JD1694/BachelorProject-BicycleCrasher/README.md

# BachelorProject: Bicycle-Crash-Detection 2021
Bachelor project at the Universität zu Lübeck about real-time crash-detection on bicycles using IMU data.

This detection acts as the basic structure for a whole safty system. Once a crash is detected, that information can be relayed to various extentions that do not need their own sensors and only little computation power. These gadgets could e.g. activate an airbag, a dashcam or call an ambulance.

|  <ins>Further Reading:</ins> | Found in: |
|---|---|
|Overview as presentation slides | Dokumentation/SensorBike_Präsentation.pdf |
|Documentation | Dokumentation/Dokumentation Bachelorprojekt.pdf |
|Materials bought: | Dokumentation/Bach.-Projekt Materialien Denker, von Waldow - Tabellenblatt1.pdf |

Crash gif with live data

Authors:
- Max-Ole von Waldow
- Julian Denker

Supervised by:
- Prof. Dr. Georg Schildbach
