JD1694/BachelorProject-BicycleCrasher/Dokumentation/Bach.-Projekt Materialien Denker, von Waldow - Tabellenblatt1.pdf

Name | Preis | Spannung in V | Größe in m² | DoF | DigitalMotionProcessor | Takt in Mhz | Link
Vergleich IMU: | Makeblock Sensor Board | 25 | 5 | 24*48 | 9 | Ja
Grove IMU 9DoF MPU9250 | 13 | 5 | 20*40 | 9 | Nein
GY-521 MPU-6050 | 9 | 3,3-5 | 21*16 | 6 | Nein | https://www.az-delivery.de/products/gy-521-6-achsen-gyroskop-und-beschleunigungssensor?variant=18568447393888 https://www.az-delivery.de/products/copy-of-spi-reader-micro-speicherkartenmodul-fur-arduino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
Pololu Min IMU-9v5 | 17 | 2,5-5.5 | 12,7*20 | 9 | Nein

Vergleich Microcontroller:

ESP-8266 | 5-10 | 3,3-3,6 | 80
Blue Pill STM32 | 5-10 | 3,3 | 72 | https://www.az-delivery.de/products/stm32f103c8t6?variant=8196210884704
Teensy | 20 | 5 | 72
Arduino | 20+ | 5 | 16 | https://www.az-delivery.de/products/esp32-developmentboard
ESP32 | 8

Zusätzlich für manche Mikrocontroller benötigt:

USB to TTL Adapter | https://www.az-delivery.de/products/hw-598-usb-auf-seriell-adapter-mit-cp2102-chip-und-kabel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
SD Reader | https://www.az-delivery.de/products/copy-of-spi-reader-micro-speicherkartenmodul-fur-arduino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
