JD1694/BachelorProject-BicycleCrasher/Dokumentation/SensorBike_Präsentation.pdf

# Bachelorprojekt

# SensorBike aka BikeCrasher

# Zielsetzung

# - Fahrradstürze mit IMU vorhersagen - Um Module erweiterbare Plattform bilden

# Vorgehensplan

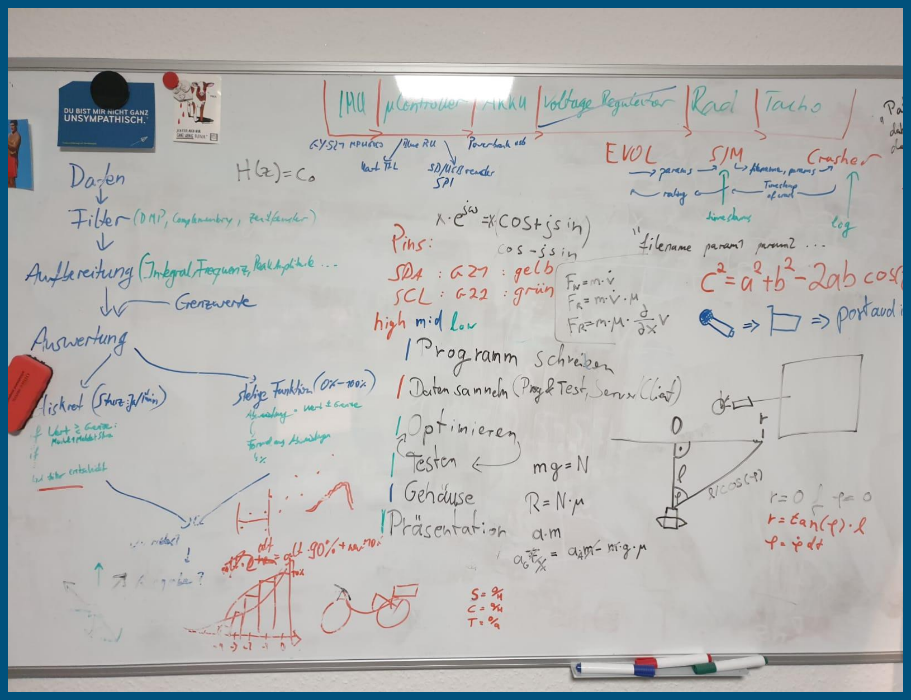
[picture p7: figure]

# - Treffen jeden Freitag - Absprache über Whatsapp und Discord - GitHub als Repository

https://github.com/JD1694/BachelorProject-BicycleCrasher

# Methoden

Daten sammeln-> ESP32-WROOM-32 mit Modulo MPU-6050 ausstatten, Clientprogramm zum Auslesen/Aufbereiten der Sensorwerte/Timestamps für Sturz in Arduino/C++, Hostprogramm empfängt Daten und schreibt in CSV in Python---->Gesammelte Sensorwerte

Auswerten der Daten-> Umschreiben des Programms zum Sammeln der Sensorwerte, sodass mithilfe der CSV eine “Simulation” ablaufen kann in C++, Sensorwerte werden aufbereitet und mit verschiedenen Thresholds verglichen, um festzustellen, ob momentan ein Sturz stattfindet. Parameter erhält das Programm von einem evolutionären Algorithmus (verschiedene Ansätze, final bruteforce) in Python, der unterschiedliche Parameter anhand der Abweichung des detektierten Sturzes verglichen mit dem aufgenommenen Timestamp bewertet---->Parameter zum erkennen eines Sturzes

Erkennen eines Sturzes->Umschreiben des Arduino/C++ Codes von Client zu Hostanwendung, wertet mit Hilfe von aufbereiteten Sensordaten und bestimmten Parametern Situation aus und sendet Informationen über Sturzverhalten/Sensordaten an Client---->Sturz erkannt

Zwischenschritte->Vorbereiten des Fahrrads (Polstern empfindlicher Stellen, abbauen des Sattels/Lichts, Aufhängung für Dummy(verworfen)), Vorbereiten des ESP(Anbringen von MPU, Einbau in gepolsterte Abzweigdose als Gehäuse)

Benötigt: Foto präpariertes Fahrrad, ESP32+MPU6050 (in Abzweigdose), Videomaterial, Codesnippets (eval, main-loop 1,2,3 Vergleich, genetic algo), Fotos von Webseite auf Handy, Plots (genAlg, Vergleich Timestamp ergebnis), Schaubilder für Vorgehen (“Datenpfad”, Optimierungskette,)

# Hardware

# Mikrocontroller: ESP32

# - integriertes Wi-Fi als Schnittstelle - 160-240MHz - FPU

# IMU: GY521-MPU

# - 3-Achsen Gyroskop und Accelerometer - DMP

# Aufbau

## Polster

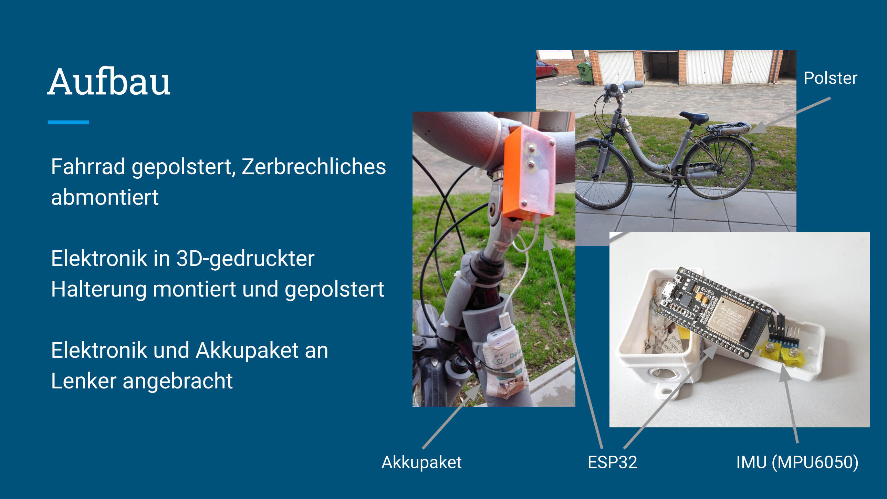
[picture p8: page 6]

# Fahrrad gepolstert, Zerbrechliches abmontiert

# Elektronik in 3D-gedruckter Halterung montiert und gepolstert

# Elektronik und Akkupaket an Lenker angebracht

Akkupaket | ESP32 | IMU (MPU6050)

# TOREMOVE - Meine Online Bildbearbeitung

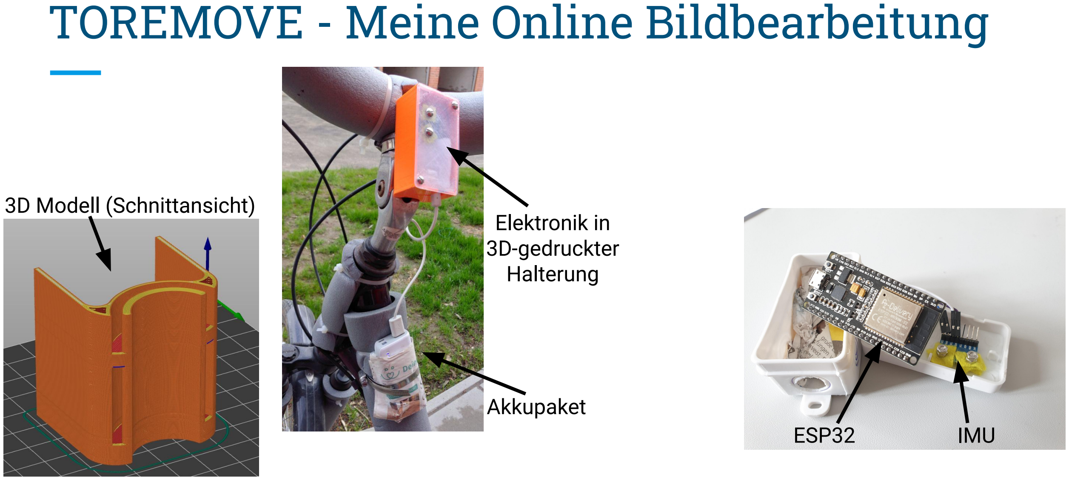
[picture p9: page 7]

## Akkupaket

ESP32 | IMU

## Elektronik in 3D-gedruckter Halterung

## 3D Modell (Schnittansicht)

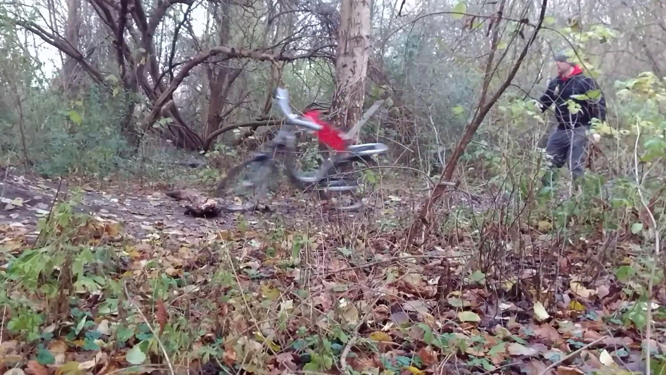
[picture p10: page 8]

# Schaubild: Daten sammeln

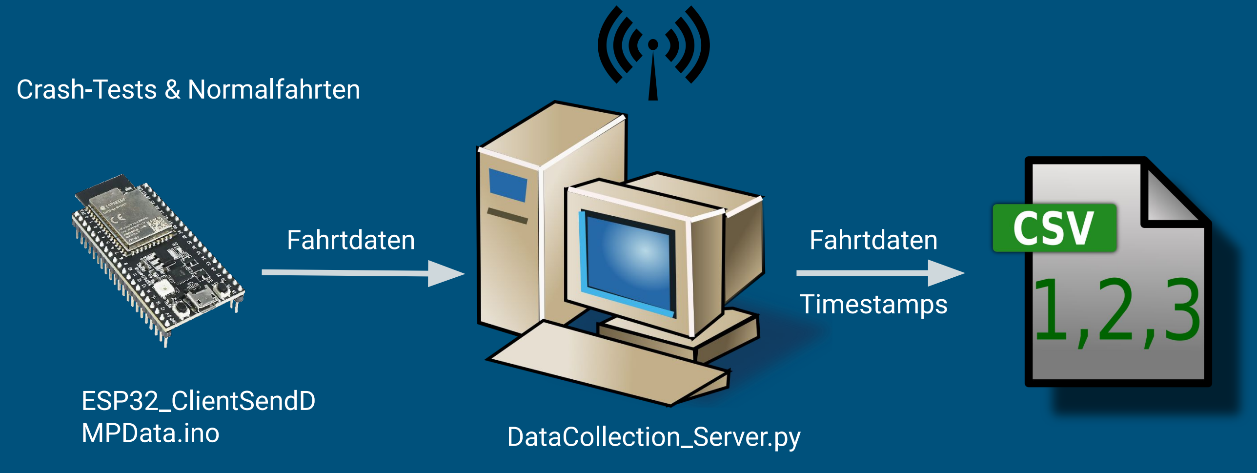
[picture p11: figure]
Fahrtdaten; Crash-Tests & Normalfahrten; ESP32_ClientSendD; MPData.ino; DataCollection_Server.py; Timestamps

# Logdatei: Normales Fahren

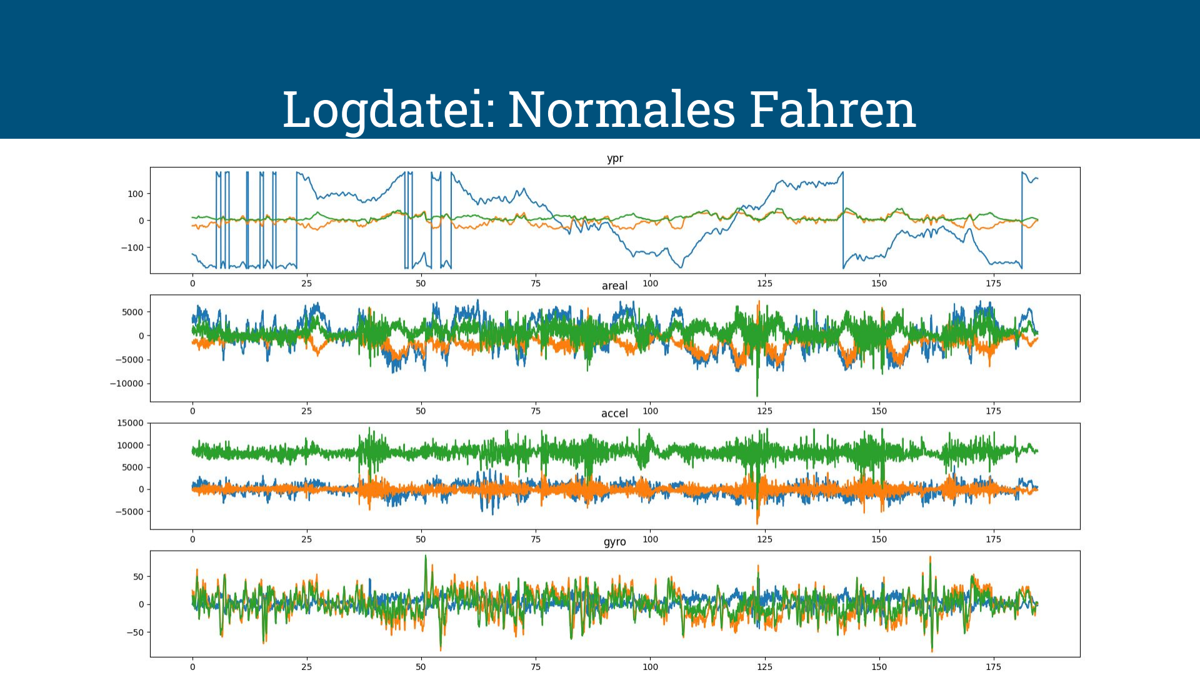
[picture p12: page 10]

# Vergleich mit bestimmten Grenzwerten

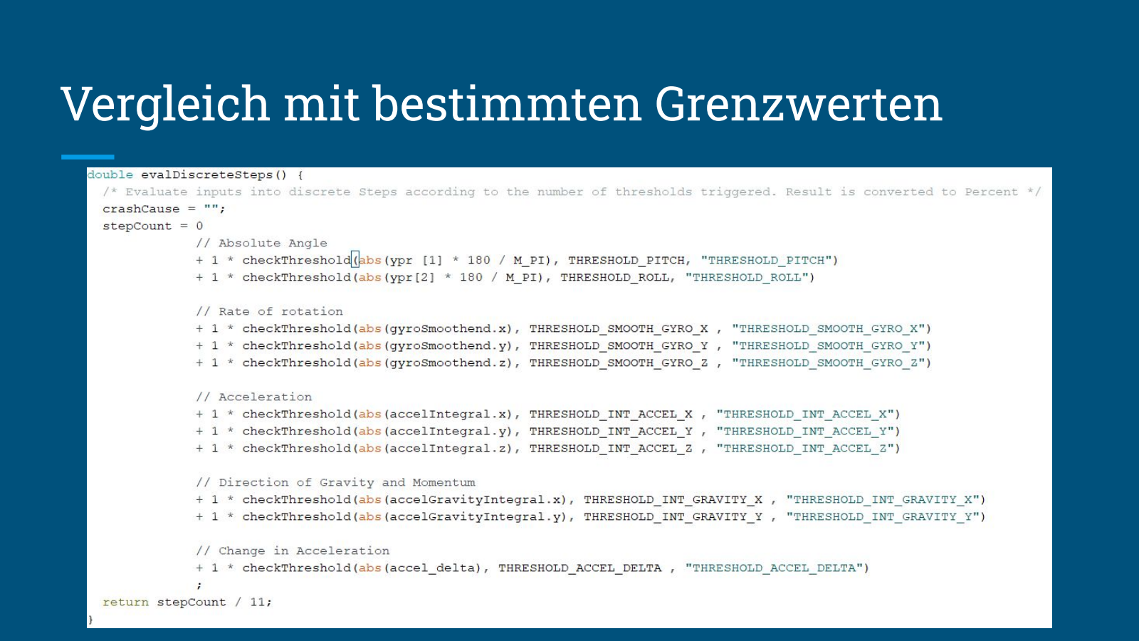
[picture p13: page 11]

# Schaubild: Trainieren

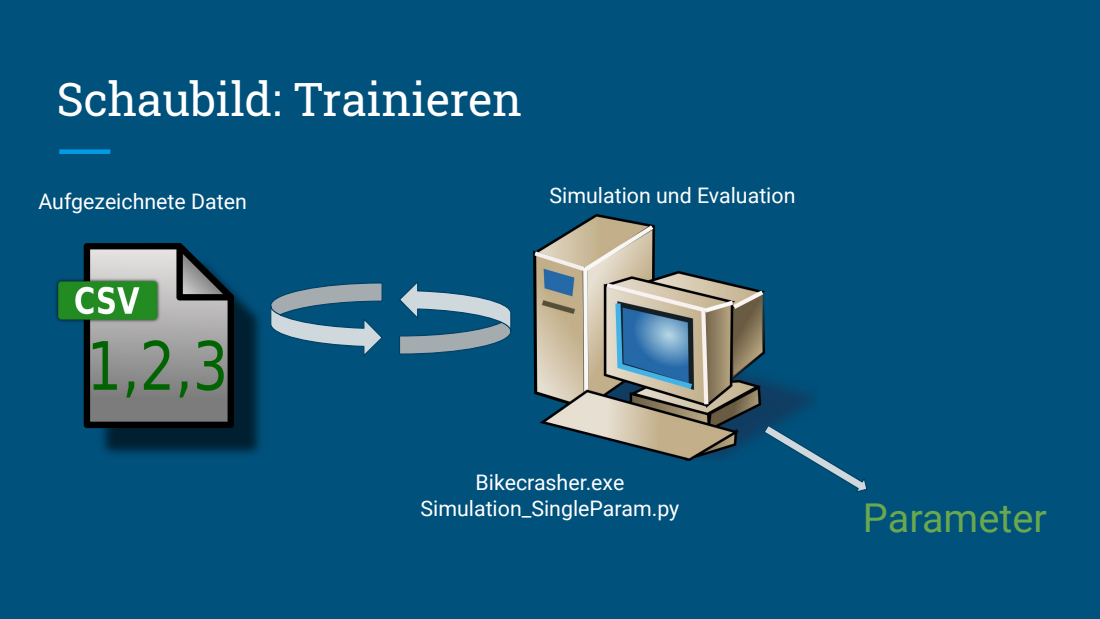
[picture p14: page 12]
Aufgezeichnete Daten; Simulation und Evaluation; Parameter; Bikecrasher.exe Simulation_SingleParam.py

# Simulation Bewertung

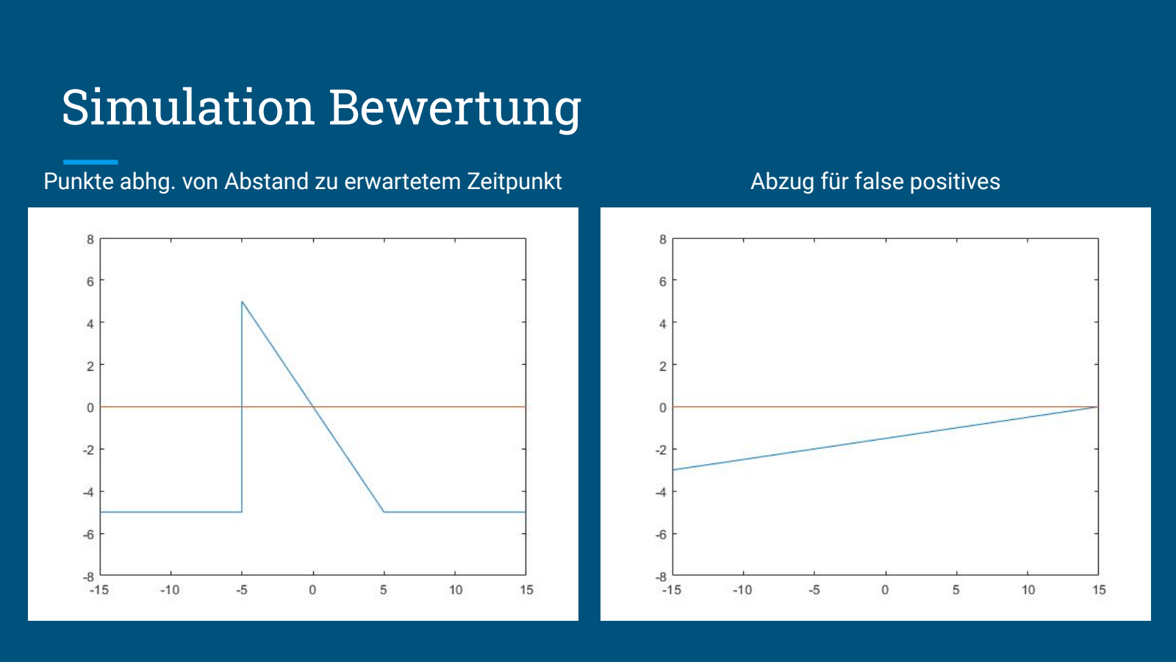
[picture p15: page 13]

Punkte abhg. von Abstand zu erwartetem Zeitpunkt | Abzug für false positives

# Schaubild: Final

Crash?
Wahrscheinlichkeit & Auslöser

## Erweiterungen

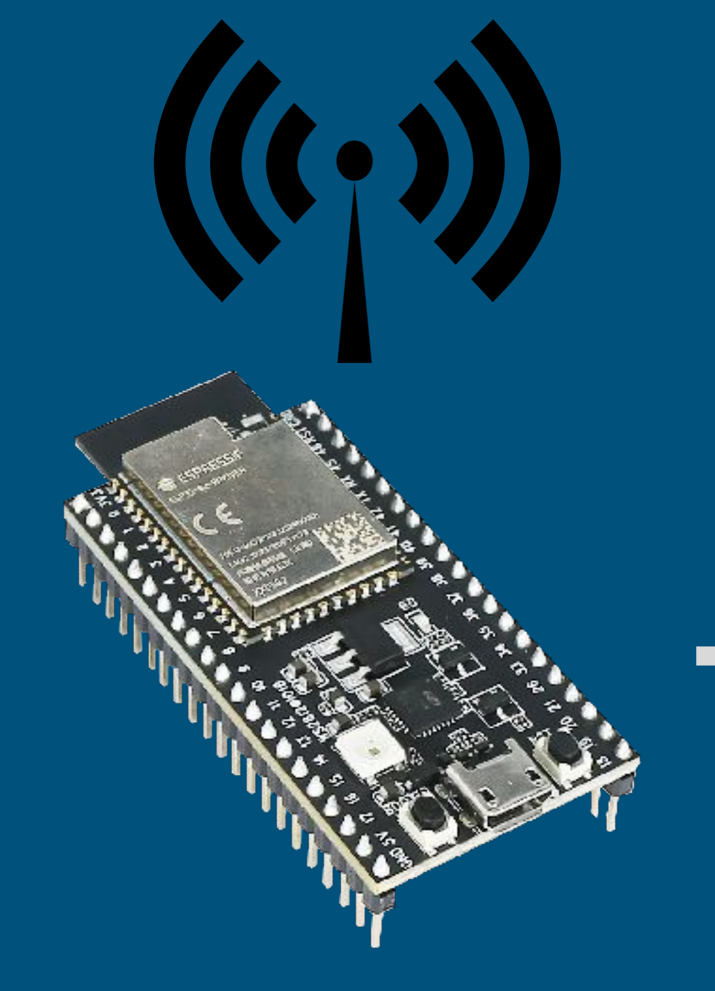
[picture p16: figure]
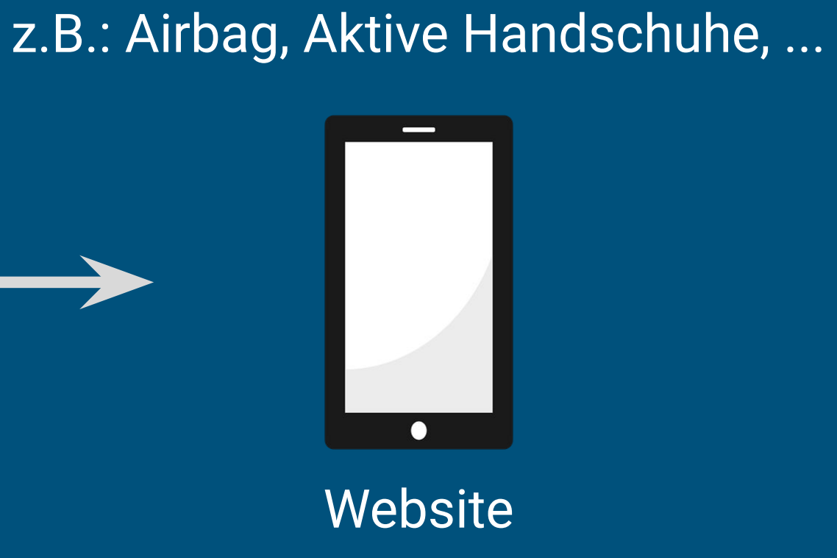
[picture p17: figure]
z.B.: Airbag, Aktive Handschuhe, ...

finalBikeCrasherServer.ino | Website

# Crash Erkennung

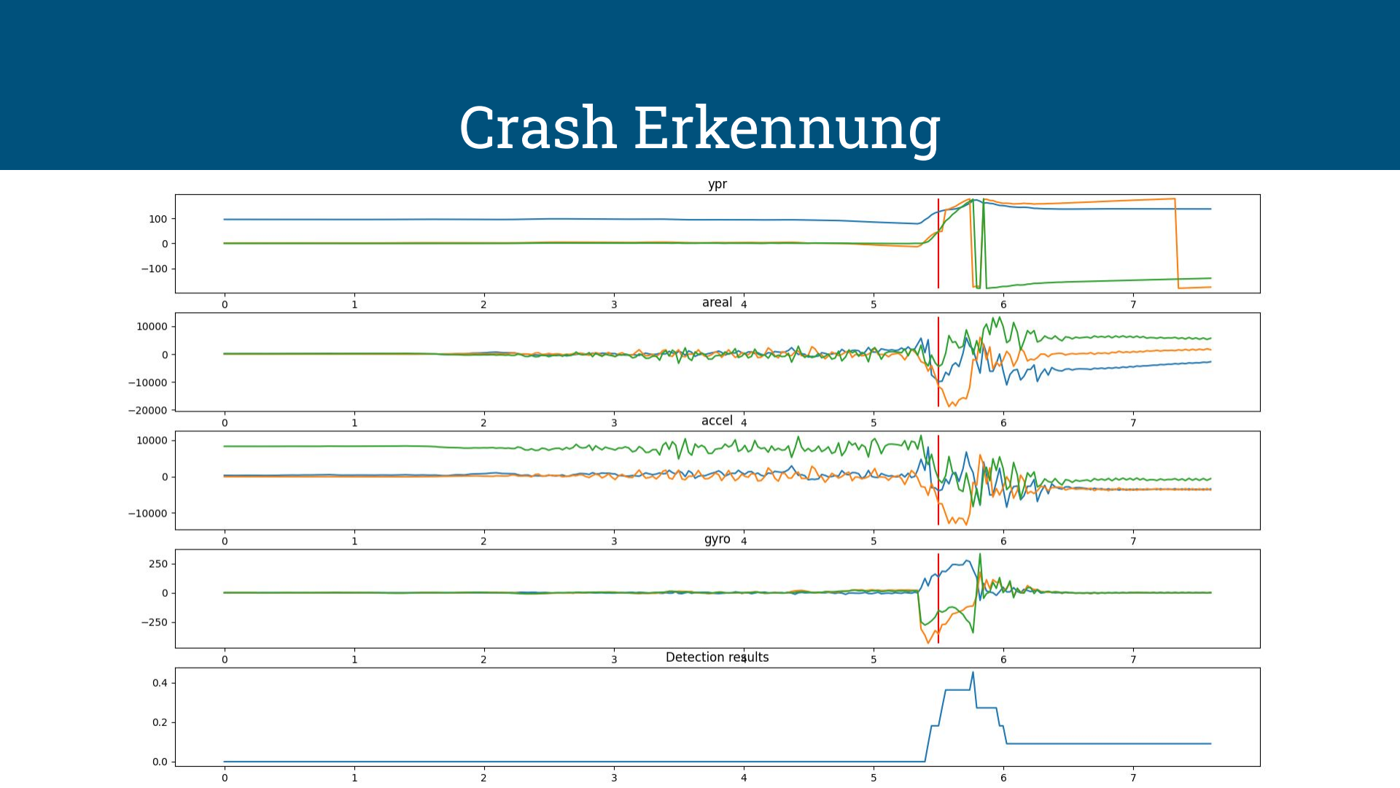
[picture p18: page 16]

# Resultate

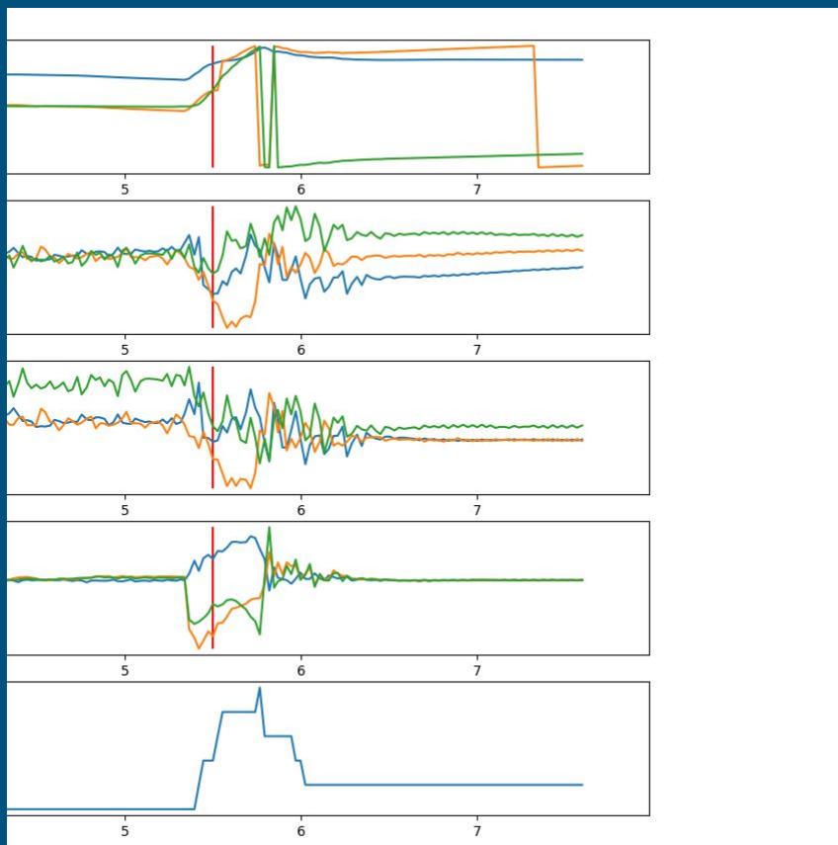
[picture p19: figure]

# - Robuste Detektion - Zeitnahe Detektion - Noch Potential für schnellere Detektion

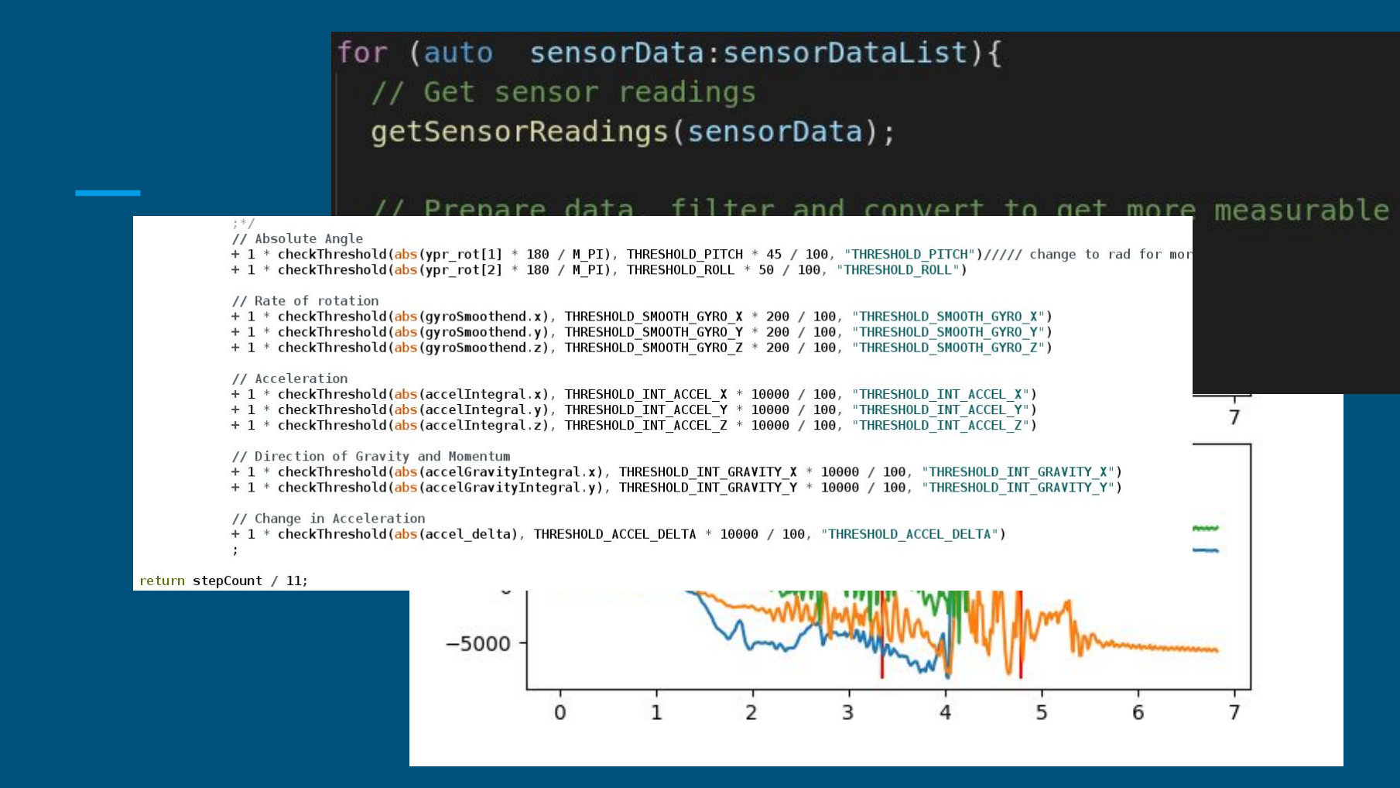
[picture p20: page 18]

# <insert Video>

# Verworfene Ideen

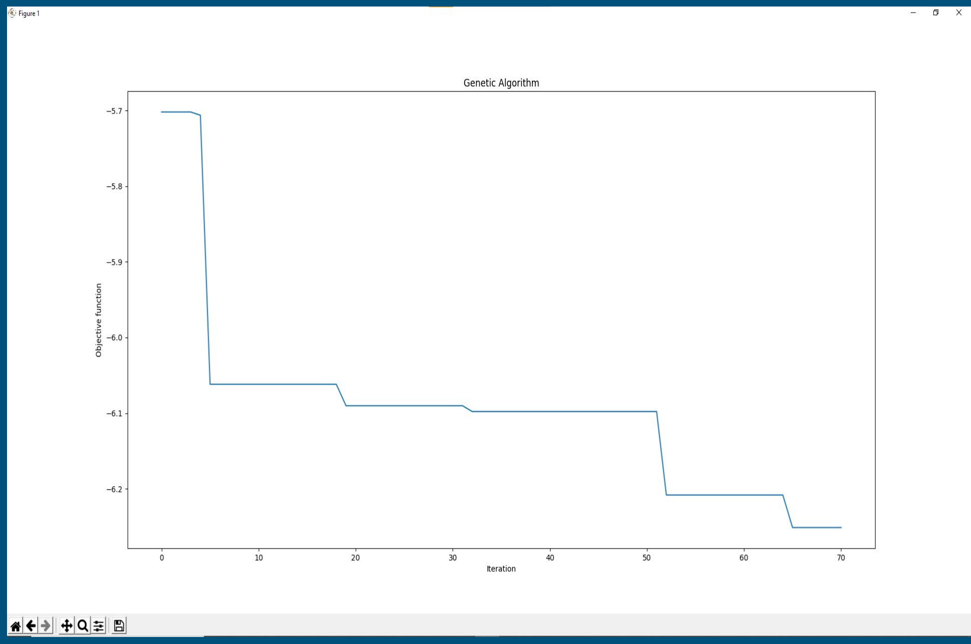
[picture p21: figure]

## Genetischer Algorithmus:

## - Optimiert Kombination aus Parametern

- Parameter voneinander unabhg.

## - GA fixiert auf einzelnen Threshold

# Verworfene Ideen

## Automatische Kalibrierung:

# - Annahme: Z-Achse per onboard tool kalibriert - → Bringe Y-Achse mit Fahrtrichtung in Übereinstimmung

## 1. Rad kippen um gewünschte Achse (hier Y) 2. Calibration_RotateCoordSys.py findet optimalen Winkel (Maximiert Y/X -Gyro-Wert)

3. Rotation aller Sensordaten um Z-Achse.

# Verworfene Ideen

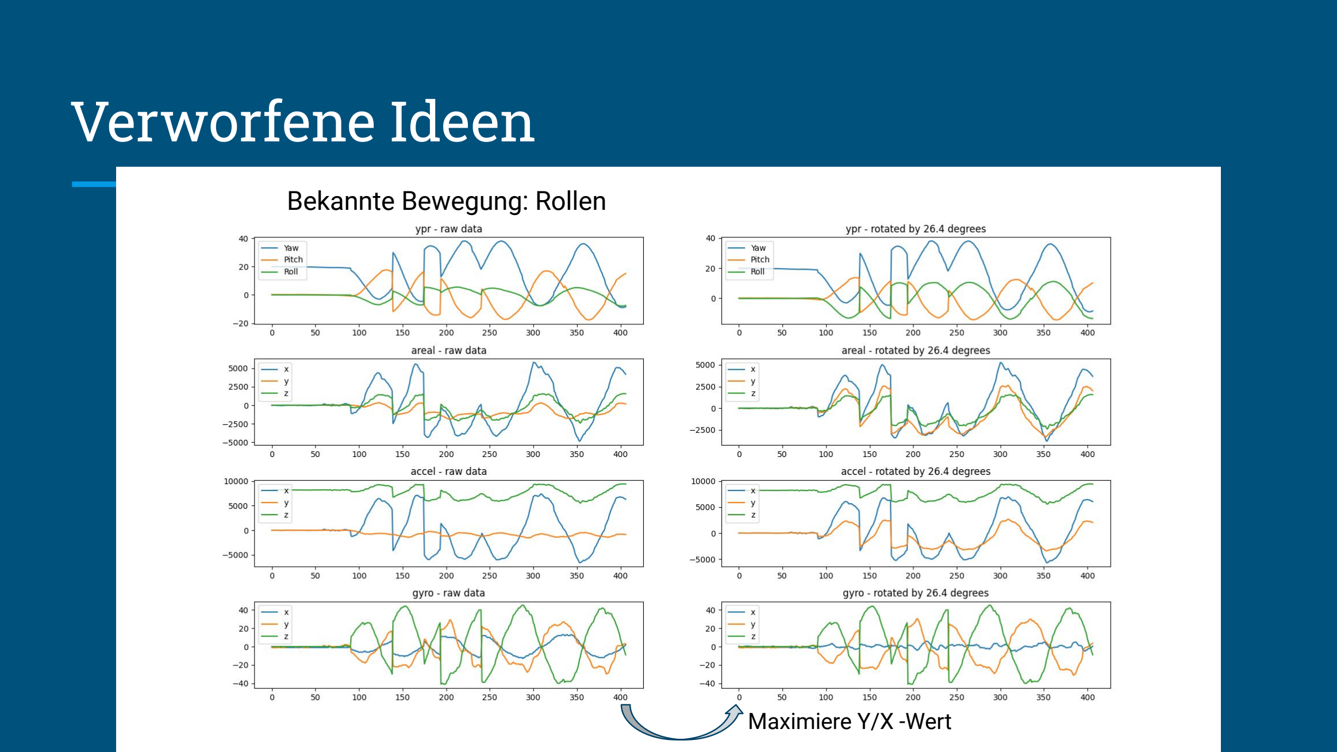
[picture p22: page 21]

### Maximiere Y/X -Wert

## Bekannte Bewegung: Rollen

# Aussicht

# - Automatische Kalibrierung des Koordinatensystems - Bessere Hardware (genauere Sensorik, mehr Rechenleistung) - Bessere Filter (Unterdrückung von Störfrequenzen) - Modellbasierte Detektion - Erweiterungsmodule

# Bildquellen (vom 24. März 2021)

PC Symbol:
https://openclipart.org/detail/17668/rgtaylor_csc_net_computer

Wlan Symbol:
https://openclipart.org/image/800px/294681

ESP32 Symbol:
https://www.antratek.de/esp32-s2-saola-1r-development-board

Handy Symbol:
https://lh3.googleusercontent.com/proxy/vMZ1PiInd5acaG9ijB2wiPms7eHR_iZPyCzsDmdI722xxvKpAT4dcUcjayGucv1MrRh_qFnxJSEfcPoqiRynX-tlRHMsuBfKhOO7-ZY0d8ANMa3N4fdIwWql0QdHl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 (https://lh3.googleusercontent.com/proxy/vMZ1PiInd5acaG9ijB2wiPms7eHR_iZPyCzsDmdI722xxvKpAT4dcUcjayGucv1MrRh_qFnxJSEfcPoqiRynX-tlRHMsuBfKhOO7-ZY0d8ANMa3N4fdIwW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)

CSV Datei Symbol:
https://lh6.googleusercontent.com/proxy/ti1-LIsHvf6kXou6rNmTxxt8GNjIud2KZ4V4aDtOjSlRAGDR9T6UI4LZAk7X-EYay166G0FYGhQa98OM4alVMh5yPy7UFG077C5NHlGwNfMC1xehFpg9Lg=w1920-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 (https://lh6.googleusercontent.com/proxy/ti1-LIsHvf6kXou6rNmTxxt8GNjIud2KZ4V4aDtOjSlRAGDR9T6UI4LZAk7X-EYay166G0FYGhQa98OM4alVMh5yPy7UFG077C5NHlGwNfMC1xehFpg9Lg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)
