JD1694/BachelorProject-BicycleCrasher/Optimization/txt/GA_Verlauf_2021-01-24 210545.png

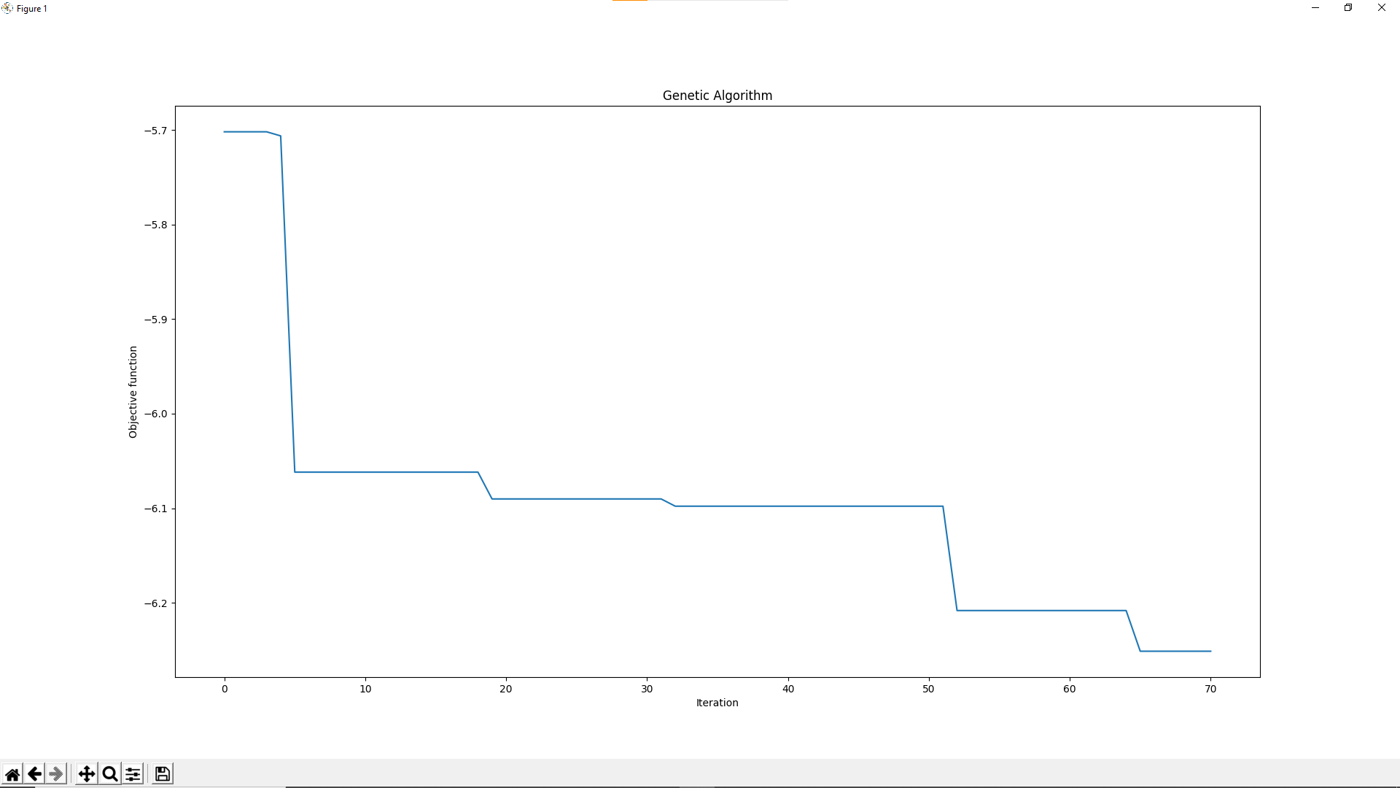
Optimization/txt/GA_Verlauf_2021-01-24 210545.png
