JD1694/BachelorProject-BicycleCrasher/(list of files, cad)

Other CAD files:
Optimization/Bikecrasher.obj
