JD1694/BachelorProject-BicycleCrasher/(commit log)

2020-10-30 added sensor data from the IMU in a mobile phone
    [SensorTracker_20190729_215033.csv, SensorTracker_20190809_155001.csv, SensorTracker_20190809_161517.csv, SensorTracker_20190905_070446.csv, SensorTracker_20190905_070511.csv, SensorTracker_20190905_113013.csv, SensorTracker_20190905_195351.csv, SensorTracker_20190908_091814.csv]
2020-11-06 added modified MPU6050 arduino library for IMU (GY-521 MPU-6050)
2020-11-06 added script to calibrate IMU and resulting IMU offsets
2020-11-06 added arduino test sketches
2020-11-08 Fixed wifi connection issue. Completed first test loging.
    [ESP32_ClientSendData_Proto.ino]
2020-11-15 updated timestamps to include microseconds. Added PlotCrash.py to visualize the data obtained including Crashtimes as marked with DataCollection_Client.py.
    [ESP32_ClientSendDMPData.ino]
2020-11-23 modified timestamps: Arduino for ESP32 has no obvious way to implement lacal time WITH Milliseconds. Now fractions of a second are estimated by the number of function calls. Jitter occours at whlóle 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
    [ESP32_ClientSendDMPData.ino]
2020-11-26 New approach to getting accurate time with method millis(). Gathered all client versions for data logging in single folder Client_to_SendData.
2020-11-27 modified how milliseconds are sent. Now with 0-padding on the left. New logs
2020-11-28 Client on ESP32 now sends raw acceleration (with gravity not removed) and raw gyro data.
2020-12-08 CrashChecker: Implemented frame of main loop and evaluation of sensor readings
    [ESP32_CrashChecker.ino]
2020-12-09 added more thresholds for evaluation of data. Added first concept of static evaluation with the norm of the distance between reading and threshold vector, an exponential average as a safe case to com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
2020-12-11 Implemented average aver accel data in CrashChecker with CircularBuffer. Added Simulation.py to rate CrashChecker for optimization with an evolutionary algorithm.
    [ESP32_CrashChecker.ino, Simulation.py]
2020-12-16 Added calibration tool to fix Y-Axis to the front and X-Axis to the right of the Bike (assuming given MPU calibration, that sets Z pointing upwards). Recycled functions from PlotCrash.py
    [Calibration_RotateCoordSys.py]
2020-12-18 new calibration values with MPU calibration tool and calibration logs for own tool
2020-12-18 Added rotation around Z-Axis (by a value yet to be determined) to orientate coord system such that y is front, x right, and z towards the top
2020-12-18 New test data, mostly of crashes. renamed calibration log files. With prefix CALIBRATION. Slight modifikation to Calibration_RotateCoordSys.py
    [Calibration_RotateCoordSys.py]
2020-12-29 added all dependencies for C++ Bikecrasher version to Optimization folder
    [Bikecrasher.obj]
2020-12-29 bugfixed calling c++ file and changed reward, especially when nothing is returned
    [Simulation.py]
2021-01-08 del misleading logs. ran Simulation results are in ParametersFound.txt. Changed Simulation for better parameter handling and unified log choosing
    [ParametersFound.txt]
2021-01-08 bugfixes: double degrees conversion, removed checkes Yaw angle and gravity Z component. Added factors for Thresholds to be in same order of magnitude. Added debug option with more output. More strict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
    [ParametersFound.txt]
2021-01-15 work on Bikecrasher: replaced buffer with moving exp average. Bug was buffer not yet filled. Added factors for each threshold so they will be near 1 for optimization.
    [ParametersFound.txt]
2021-01-22 Added Z-Axis rotattion for calibration to Bikecrasher.cpp. Added Genetic Algorithm to Simulation as Simulation_and_GA.py
    [ParametersFound.txt]
2021-01-28 improved LogUpdater, used it to perfect logs, used those in Simulation_and_GA for a 6hour run.
    [ParametersFound.txt]
2021-02-03 Bug fix in Simulation_and_GA: list index out of range in print statement
    [Simulation_and_GA.py]
2021-02-05 Added more files to Simulation_and_GA2, updated the logs now used in Simulation_and_GA2, added new found parameters, deleted logs that arent useful
    [ParametersFound.txt]
2021-02-05 new parameters
    [ParametersFound.txt]
2021-02-27 Added BikeCrasherServer
    [ParametersFound.txt]
2021-03-08 Fixed bug where new Data was not red from buffer. Output now contains type of threshold violation.
    [finalBikeCrasherServer.ino]
2021-03-12 added parameters
    [ParametersFound.txt]
2021-03-15 testing new thresholds
    [ParametersFound.txt]
2021-03-24 Experimenting with new calibrations for coordinate systems
    [ParametersFound.txt]
2021-03-24 minor changes in Bikecrasher.rotateZ+Simulation_SingleParam.antifalsepositives added values to ParametersFound.txt
    [ParametersFound.txt]
2021-03-29 fixed Bug in Optimization: Simulation_SingleParam.py where Threshold would be turned off by passing Zero. Improved Threshold for THRESHOLD_INT_GRAVITY_X
    [ParametersFound.txt]
2021-04-01 added new parameters in parametersFound
    [ParametersFound.txt]
2021-04-08 Added new Parameters and removed traces of old rotationZ
    [ParametersFound.txt]
2021-05-03 removed uncorrelated Sensordata from different sensor
    [SensorTracker_20190729_215033.csv, SensorTracker_20190809_155001.csv, SensorTracker_20190809_161517.csv, SensorTracker_20190905_070446.csv, SensorTracker_20190905_070511.csv, SensorTracker_20190905_113013.csv, SensorTracker_20190905_195351.csv, SensorTracker_20190908_091814.csv]
2021-05-03 removed scripts unrelated to final project and just used for experimenting with the sensors in a phone
2021-05-07 replaced materials document
2021-05-07 removede unnecessary files
    [ParametersFound.txt]
